PA0LUX/Yaesu-FTdx-101-tune-button/Schematic Tune button with FM.jpg

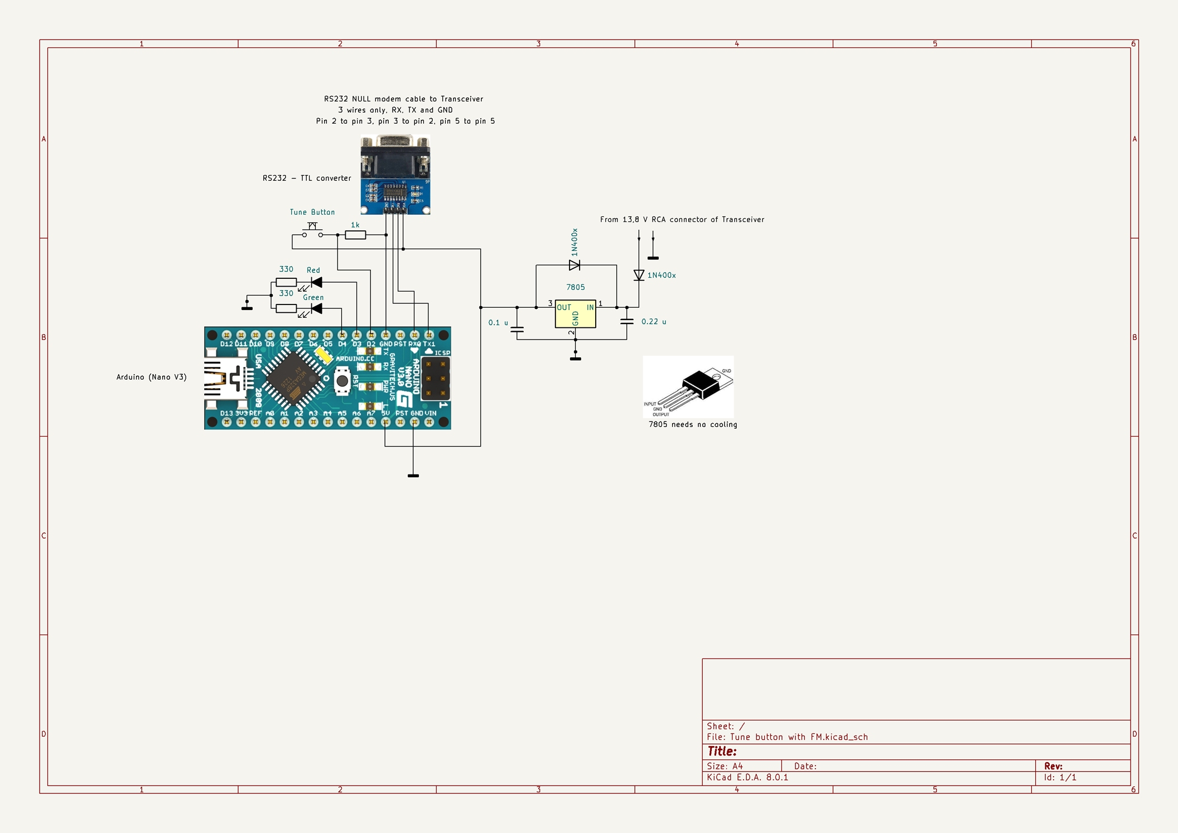
Schematic Tune button with FM.jpg
