PA0LUX/Yaesu-FTdx-101-tune-button/Schematic Tune button with TxReq.jpg

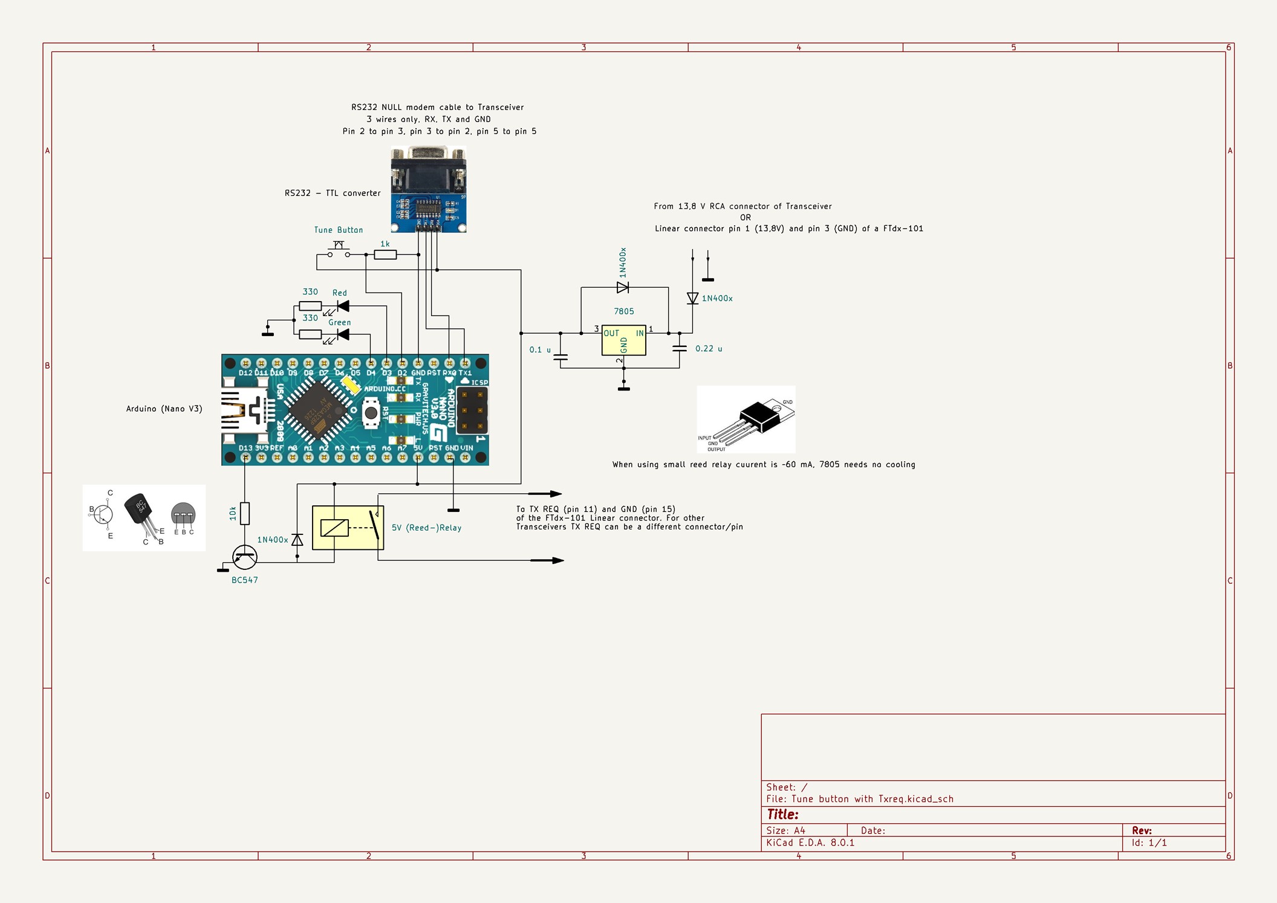
Schematic Tune button with TxReq.jpg
